Defconbots/2015_target/hw/boards/bom.md

## Control/Battery BOM

|Name |Quantity|Part Number |Distributor|
|:---:|:---:|:---:|:---:|
|BAT1, BAT2, BAT3|3 |534-082 |Mouser |
|U1 |1 |579-MCP1703T-3002ECB|Mouser |
|S1 |1 |612-EG1270 |Mouser |
|R1, R2, R3 |3 |71-CRCW0603-10K-E3  |Mouser |
|R4 |1 |71-CRCW0603220RFKEB |Mouser |
|U2 |1 |771-LPC824M201JDH20J|Mouser |
|JP2 |1 |798-DF132P125V20 |Mouser |
|JP3 |1 |798-DF134P125V20 |Mouser |
|U3 |1 |888-XB24CZ7PIS-004  |Mouser |
|C1, C2 |2 |C1608X5R1C106M080AB |Mouser |
|JP1 |1 |FTSH-105-01-L |Samtec |

## Target BOM

|Name |Quantity|Part Number |Distributor|
|:---:|:---:|:---:|:---:|
|D1, D2 |2 |150141RB73100 |Mouser |
|U1 |1 |579-MCP1703T-3002ECB|Mouser |
|U4 |1 |579-MCP6291T-E/OT |Mouser |
|D3 |1 |638-CLS1522CL213GTR8|Mouser |
|R7 |1 |71-CRCW0603-10K-E3  |Mouser |
|R2, R4 |2 |71-CRCW0603-5.6-E3  |Mouser |
|R5, R6 |2 |71-CRCW0603220RFKEB |Mouser |
|R8 |1 |71-CRCW06034M64FKEA |Mouser |
|R1, R3 |2 |71-CRCW060368R0FKEB |Mouser |
|T1 |1 |771-BC847BS-T/R |Mouser |
|U2 |1 |771-LPC824M201JDH20J|Mouser |
|JP1, JP2 |2 |798-DF134P125V20 |Mouser |
|C1, C2 |2 |C1608X5R1C106M080AB |Mouser |
|JP3 |1 |M50-3600542 |Mouser |

## Control/Target Interconnects

|Name |Quantity|Part Number |Distributor|
|:---:|:---:|:---:|:---:|
|N/A |1 |798-DF13-2S-1.25C |Mouser |
|N/A |11 |798-DF13-4S-1.25C |Mouser |
|N/A |30 |H4BBG-10110-B1-ND |Digikey |

## Misc Interface

|Name |Quantity|Part Number |Distributor|
|:---:|:---:|:---:|:---:|
|N/A |1 |602-1144-ND |Digikey |
|N/A |1 |771-OM13071598 |Mouser |
