Defconbots/2015_target/hw/boards/control_bat.brd

## EAGLE design hw/boards/control_bat.brd (2015-07-31)

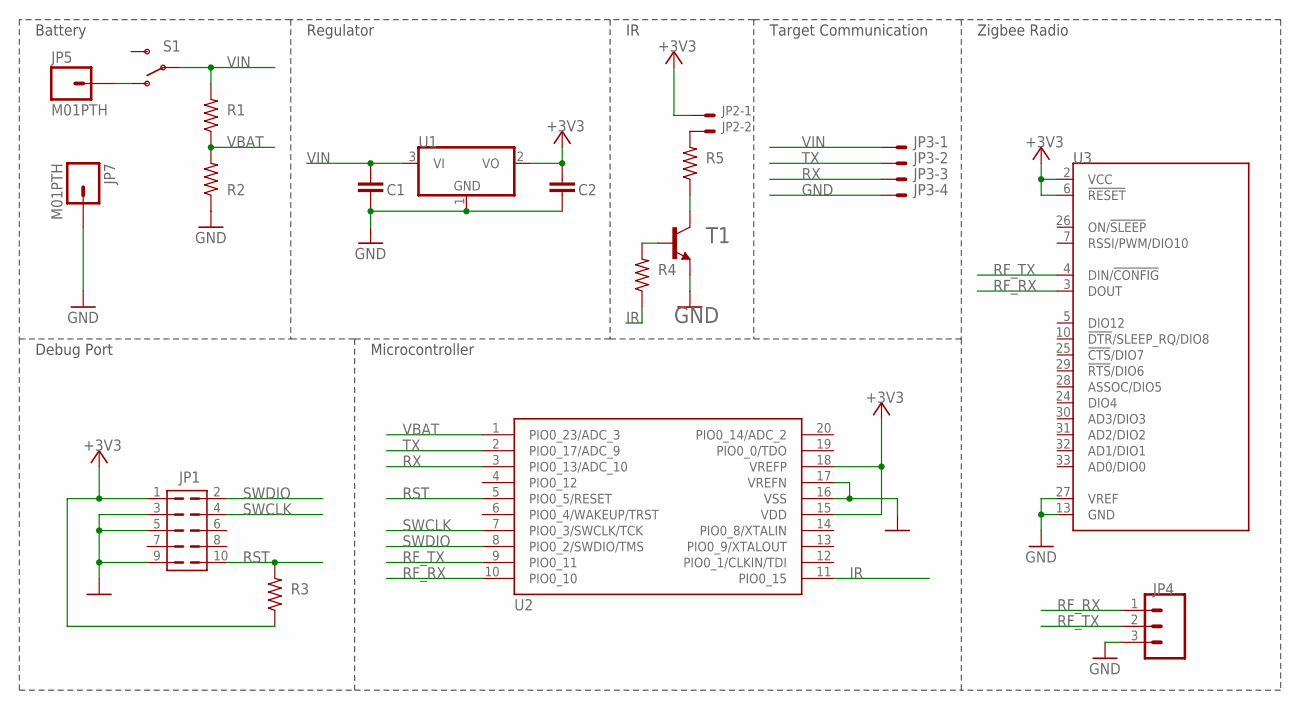
[picture p1: schematic control_bat.sch]

Parts:
C1, C2: C1608X5R1C106M080AB; 0603-CAP
JP1: FTSH-105-01-L; FTSH-105-01-XXX-DV-K
JP2: 798-DF132P125V20; 53398-02
JP3: 798-DF134P125V20; 53398-04
JP4: M03PTH; 1X03
JP5, JP7: M01PTH; 1X01
R1, R2, R3: 71-CRCW0603-10K-E3; R0603
R4: 71-CRCW0603220RFKEB; R0603
R5: 71-CRCW0603-5.6-E3; R0603
S1: 612-EG1270; EG1270
T1: PMBT4401,215; SOT23-BEC
U1: 579-MCP1703T-3002ECB; SOT23
U2: 771-LPC824M201JDH20J; TSSOP20
U3: 888-XB24CZ7PIS-004; XBEE-SMT

Connections:
+3V3: C2.1, JP1.1, JP2.1, R3.1, U1.2 (VO), U2.15 (VDD), U2.18 (VREFP), U3.2 (VCC), U3.6 (!RESET)
GND: C1.2, C2.2, JP1.3, JP1.5, JP1.9, JP3.4, JP4.3, JP7.1, R2.1, T1.E, U1.1 (GND), U2.16 (VSS), U2.17 (VREFN), U3.13 (GND), U3.27 (VREF)
IR: R4.1, U2.11 (PIO0_15)
unnamed: JP5.1, S1.P$1 (O)
unnamed: JP2.2, R5.2
unnamed: R5.1, T1.C
unnamed: R4.2, T1.B
RF_RX: JP4.1, U2.10 (PIO0_10), U3.3 (DOUT)
RF_TX: JP4.2, U2.9 (PIO0_11), U3.4 (DIN/!CONFIG)
RST: JP1.10, R3.2, U2.5 (PIO0_5/RESET)
RX: JP3.3, U2.3 (PIO0_13/ADC_10)
SWCLK: JP1.4, U2.7 (PIO0_3/SWCLK/TCK)
SWDIO: JP1.2, U2.8 (PIO0_2/SWDIO/TMS)
TX: JP3.2, U2.2 (PIO0_17/ADC_9)
VBAT: R1.1, R2.2, U2.1 (PIO0_23/ADC_3)
VIN: C1.1, JP3.1, R1.2, S1.P$2, U1.3 (VI)

Notes on the sheet:
Regulator
Microcontroller
Debug Port
Battery
Target Communication
Zigbee Radio

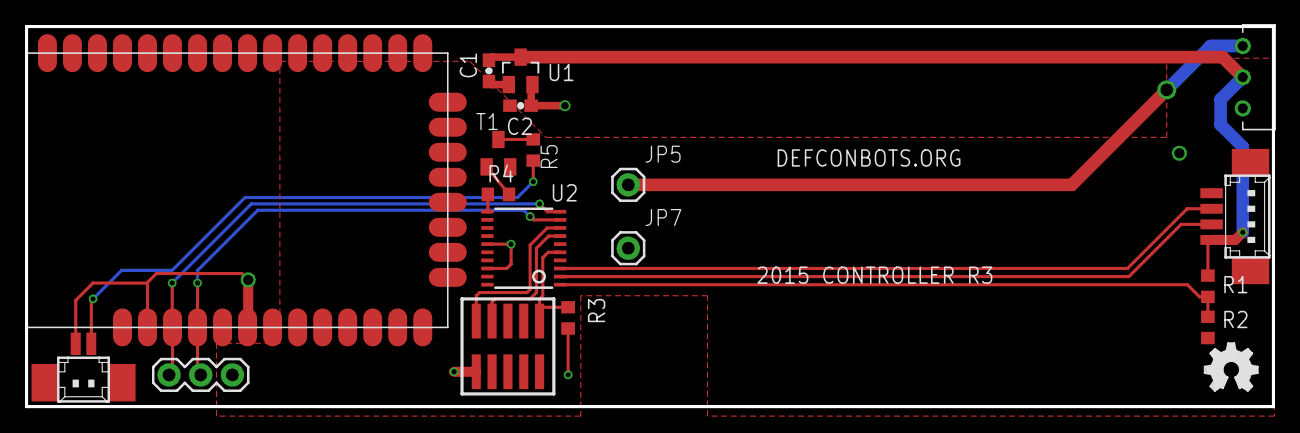
[picture p2: board control_bat.brd from above]

Board: 2 copper layers, 100.0 x 30.5 mm, 19 parts (0 on the bottom side), 16 nets.

Other parts of the board:
LOGO1: OSHW_LOGO_FILLX0150-NT; OSHW_FILLX150_NOTEXT
