Defconbots/2015_target/hw/boards/target.brd

## EAGLE design hw/boards/target.brd (2014-11-25)

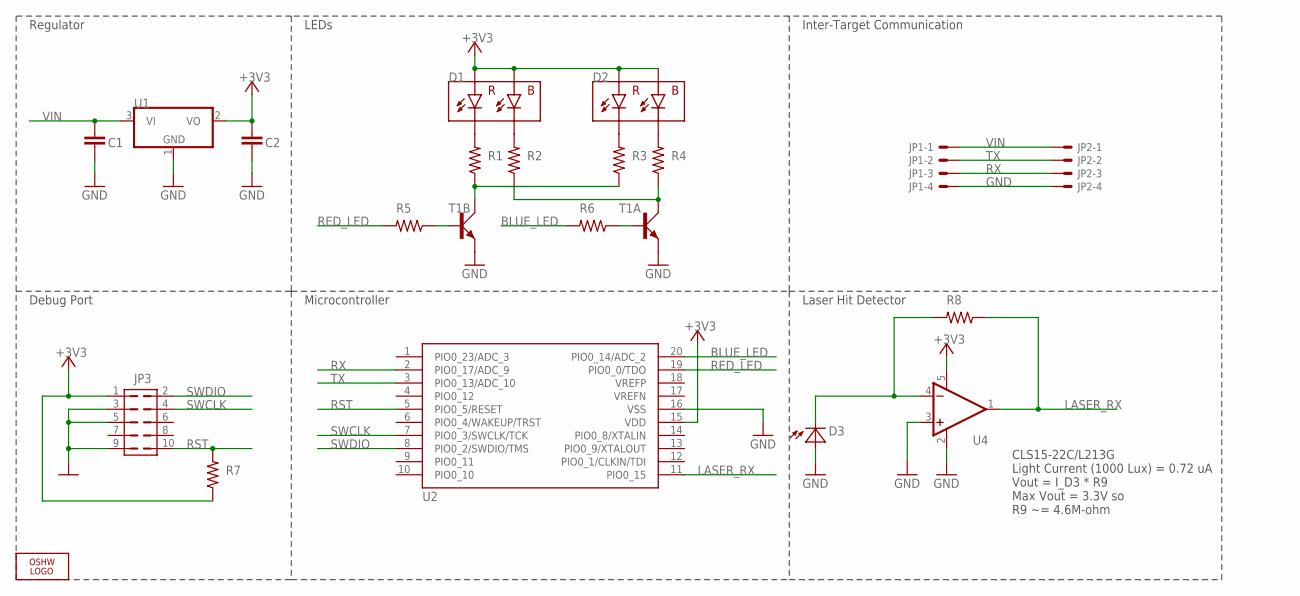
[picture p3: schematic target.sch]

Parts:
C1, C2: C1608X5R1C106M080AB; 0603-CAP
D1, D2: 150141RB73100; 150141RB
D3: 638-CLS1522CL213GTR8; CLS15
JP1, JP2: 798-DF134P125V20; 53398-04
JP3: FTSH-105-01-L; FTSH-105-01-XXX-DV-K
LOGO2: OSHW_LOGO_FILLX0150-NT; OSHW_FILLX150_NOTEXT
R1, R3: 71-CRCW060368R0FKEB; R0603
R2, R4: 71-CRCW0603-5.6-E3; R0603
R5, R6: 71-CRCW0603220RFKEB; R0603
R7: 71-CRCW0603-10K-E3; R0603
R8: 71-CRCW06034M64FKEA; R0603
T1: 771-BC847BS-T/R; SOT363_PHILIPS
U1: 579-MCP1703T-3002ECB; SOT23
U2: 771-LPC824M201JDH20J; TSSOP20
U4: 579-MCP6291T-E/OT; SOT23-5

Connections:
+3V3: C2.1, D1.1, D1.2, D2.1, D2.2, JP3.1, R7.1, U1.2 (VO), U2.15 (VDD), U4.5 (V+)
BLUE_LED: R6.2, U2.20 (PIO0_14/ADC_2)
GND: C1.2, C2.2, D3.1 (A), D3.2 (A), JP1.4, JP2.4, JP3.3, JP3.5, JP3.9, T1.1 (E), T1.4 (E), U1.1 (GND), U2.16 (VSS), U4.2 (V-), U4.3 (+IN)
LASER_RX: R8.1, U2.11 (PIO0_15), U4.1 (OUT)
unnamed: R2.1, R4.1, T1.6 (C)
unnamed: R1.1, R3.1, T1.3 (C)
unnamed: D1.3, R1.2
unnamed: R6.1, T1.2 (B)
unnamed: D3.3 (C), D3.4 (C), R8.2, U4.4 (-IN)
unnamed: D2.3, R3.2
unnamed: D1.4, R2.2
unnamed: D2.4, R4.2
unnamed: R5.1, T1.5 (B)
RED_LED: R5.2, U2.19 (PIO0_0/TDO)
RST: JP3.10, R7.2, U2.5 (PIO0_5/RESET)
RX: JP1.3, JP2.3, U2.2 (PIO0_17/ADC_9)
SWCLK: JP3.4, U2.7 (PIO0_3/SWCLK/TCK)
SWDIO: JP3.2, U2.8 (PIO0_2/SWDIO/TMS)
TX: JP1.2, JP2.2, U2.3 (PIO0_13/ADC_10)
VIN: C1.1, JP1.1, JP2.1, U1.3 (VI)

Notes on the sheet:
Regulator
LEDs
Inter-Target Communication
Microcontroller
Debug Port
Laser Hit Detector
CLS15-22C/L213G Light Current (1000 Lux) = 0.72 uA Vout = I_D3 * R9 Max Vout = 3.3V so R9 ~= 4.6M-ohm

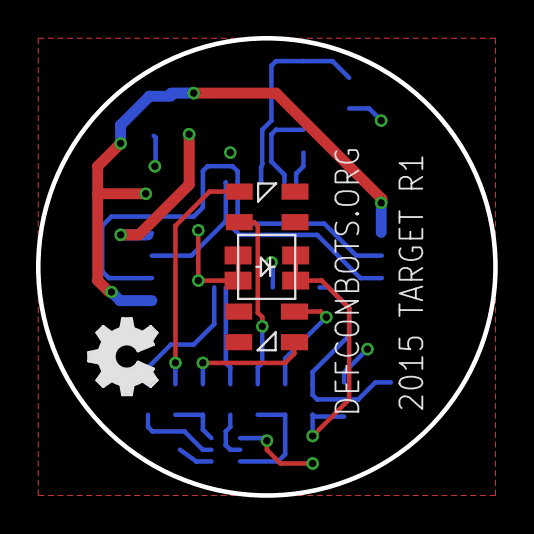
[picture p4: board target.brd from above]

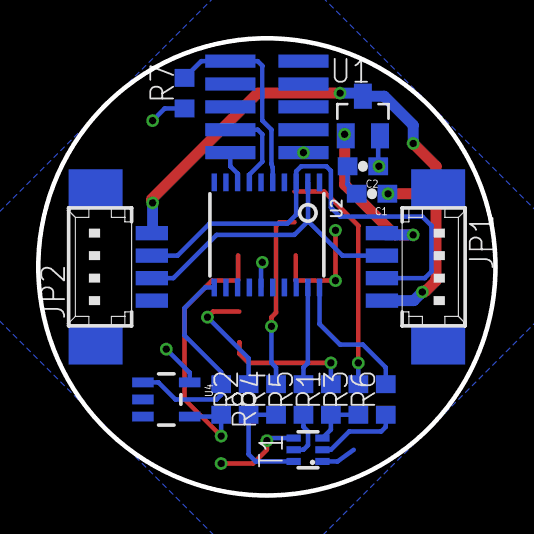
[picture p5: board target.brd from below]

Board: 2 copper layers, 25.4 x 25.4 mm, 21 parts (17 on the bottom side), 20 nets.
