Defconbots/2015_target/boards/main.brd

## EAGLE design boards/main.brd (2014-11-07)

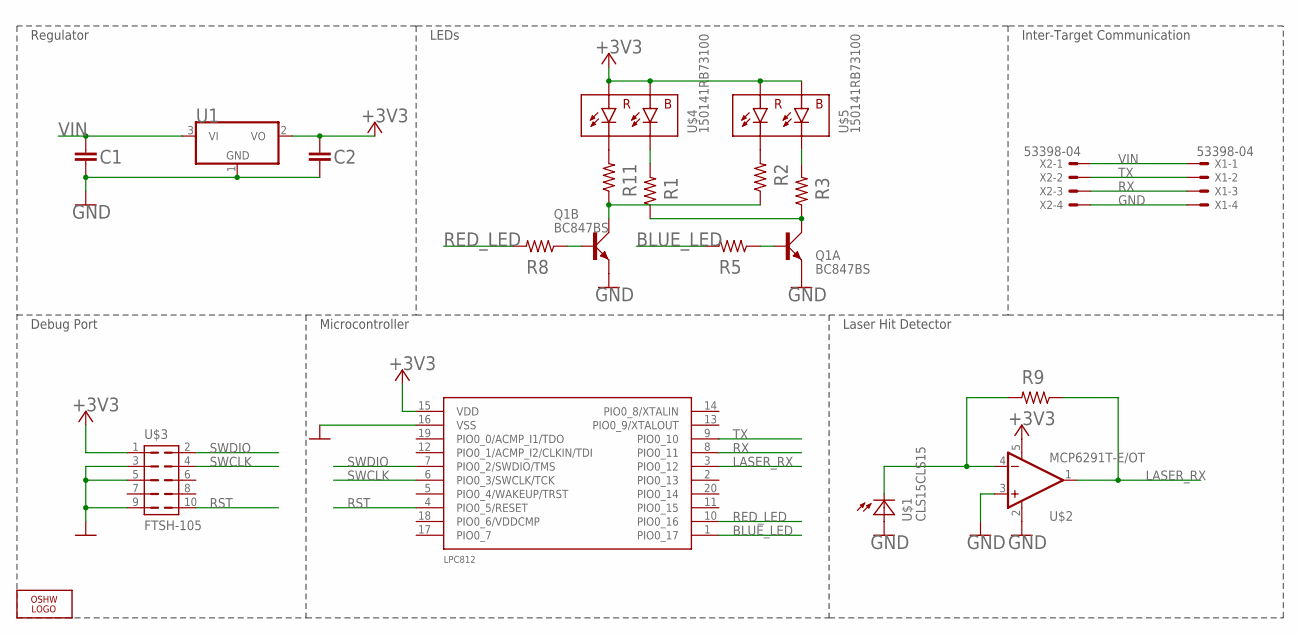
[picture p6: schematic main.sch]

Parts:
C1, C2: C1608X5R1C106M080AB; 0603-CAP
LOGO2: OSHW_LOGO_FILLX0150-NT; OSHW_FILLX150_NOTEXT
LPC812: LPC812M101JDH20; TSSOP20
Q1: BC847BS; SOT363_PHILIPS
R1, R2, R3, R5, R8, R9, R11: CRCW0603200RFKEA; R0603
U1: MCP1703T-3002E/CB; SOT23
U$1: CLS15CLS15; CLS15
U$2: MCP6291T-E/OT; SOT23-5
U$3: FTSH-105; FTSH-105-01-XXX-DV-K
U$4, U$5: 150141RB73100; 150141RB
X1, X2: 53398-04

Connections:
+3V3: C2.1, LPC812.15 (VDD), U1.2 (VO), U$2.5 (V+), U$3.1, U$4.1, U$4.2, U$5.1, U$5.2
BLUE_LED: LPC812.1 (PIO0_17), R5.2
GND: C1.2, C2.2, LPC812.16 (VSS), Q1.1 (E), Q1.4 (E), U1.1 (GND), U$1.1 (A), U$1.2 (A), U$2.2 (V-), U$2.3 (+IN), U$3.3, U$3.5, U$3.9, X1.4, X2.4
LASER_RX: LPC812.3 (PIO0_12), R9.1, U$2.1 (OUT)
unnamed: Q1.6 (C), R1.1, R3.1
unnamed: Q1.3 (C), R2.1, R11.1
unnamed: R11.2, U$4.3
unnamed: Q1.2 (B), R5.1
unnamed: R9.2, U$1.3 (C), U$1.4 (C), U$2.4 (-IN)
unnamed: R2.2, U$5.3
unnamed: R1.2, U$4.4
unnamed: R3.2, U$5.4
unnamed: Q1.5 (B), R8.1
RED_LED: LPC812.10 (PIO0_16), R8.2
RST: LPC812.4 (PIO0_5/RESET), U$3.10
RX: LPC812.8 (PIO0_11), X1.3, X2.3
SWCLK: LPC812.6 (PIO0_3/SWCLK/TCK), U$3.4
SWDIO: LPC812.7 (PIO0_2/SWDIO/TMS), U$3.2
TX: LPC812.9 (PIO0_10), X1.2, X2.2
VIN: C1.1, U1.3 (VI), X1.1, X2.1

Notes on the sheet:
Regulator
LEDs
Inter-Target Communication
Microcontroller
Debug Port
Laser Hit Detector

Board: 2 copper layers, 20 parts (16 on the bottom side), 20 nets, no tracks yet.
