Defconbots/2015_target/sw/driver_lib/inc/iocon_8xx.h

/*
 * @brief LPC8xx IOCON register block and driver
 *
 * @note
 * Copyright(C) NXP Semiconductors, 2012
 * All rights reserved.
 *
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
 * @par
 * Permission to use, copy, modify, and distribute this software and its
 * documentation is hereby granted, under NXP Semiconductors' and its
 * licensor's relevant copyrights in the software, without fee, provided that it
 * is used in conjunction with NXP Semiconductors microcontrollers.  This
 * copyright, permission, and disclaimer notice must appear in all copies of
 * this code.
 */

#ifndef __IOCON_8XX_H_
#define __IOCON_8XX_H_

#ifdef __cplusplus
extern "C" {
#endif

/** @defgroup IOCON_8XX CHIP: LPC8xx IOCON register block and driver
 * @ingroup CHIP_8XX_Drivers
 * @{
 */

#define NUM_IOCON_PIO  (29)

/**
 * @brief Array of IOCON pin definitions passed to Chip_IOCON_SetPinMuxing() must be in this format
 */
typedef struct {
	uint32_t pin:8;			/* Pin number */
	uint32_t modefunc:24;	/* Function and mode */
} PINMUX_GRP_T;

/**
 * @brief	IOCON register block structure
 * @note	When accessing this register structure, use the PIOn enumeration
 * as the array index as the pin assignments are not mapped 1-1 with the
 * IOCON structure.<br>
 * Incorrect: LPC_IOCON->PIO0[0] = 0x1; // Index 0 does not map to pin 0!<br>
 * Correct: LPC_IOCON->PIO0[IOCON_PIO0] = 0x1; // Enumeration PIO0 maps to pin 0
 */
typedef struct {		/*!< (@ 0x40044000) IOCONFIG Structure     */
	__IO uint32_t PIO0[NUM_IOCON_PIO + 2]; /* 2 added for reserved register */
} LPC_IOCON_T;

/**
 * @brief IOCON Register bit definitions
 */
/* Pin Mode mask */
#define PIN_MODE_MASK           (0x3 <<  3)
#define PIN_MODE_BITNUM         (3)

/* Pin Hysteresis mask */
#define PIN_HYS_MASK            (0x1 <<  5)
#define PIN_HYS_BITNUM          (5)

/* Pin invert input mask */
#define PIN_INV_MASK            (0x1 <<  6)
#define PIN_INV_BITNUM          (6)

/* Pin open drain mode mask */
#define PIN_OD_MASK             (0x1 << 10)
#define PIN_OD_BITNUM           (10)

/* Pin digital filter sample mode mask */
#define PIN_SMODE_MASK          (0x3 << 11)
#define PIN_SMODE_BITNUM        (11)

/* Pin clock divider mask */
#define PIN_CLKDIV_MASK         (0x7 << 13)
#define PIN_CLKDIV_BITNUM       (13)

/* Pin I2C mode mask - valid for PIO10 & PIO11 only */
#define PIN_I2CMODE_MASK        (0x3 <<  8)
#define PIN_I2CMODE_BITNUM      (8)

/**
 * @brief IOCON Pin Numbers enum
 * Maps a pin number to an IOCON (register) array index. IOCON indexes
 * are not mapped 1-1 with pin numbers. When access the PIO0 array in
 * the LPC_IOCON_T structure, the array should be indexed with one of
 * these enumerations based on the pin that will have it's settings
 * changed.<br>
 * Example: LPC_IOCON->PIO0[IOCON_PIO0] = 0x1; // Enumeration PIO0 maps to pin 0
 */
typedef enum CHIP_PINx {
	IOCON_PIO0  =  0x11,	/*!< PIN 0 */
	IOCON_PIO1  =  0x0B,	/*!< PIN 1 */
	IOCON_PIO2  =  0x06,	/*!< PIN 2 */
	IOCON_PIO3  =  0x05,	/*!< PIN 3 */
	IOCON_PIO4  =  0x04,	/*!< PIN 4 */
	IOCON_PIO5  =  0x03,	/*!< PIN 5 */
	/* The following pins are not present in DIP8 packages */
	IOCON_PIO6  =  0x10,	/*!< PIN 6 */
	IOCON_PIO7  =  0x0F,	/*!< PIN 7 */
	IOCON_PIO8  =  0x0E,	/*!< PIN 8 */
	IOCON_PIO9  =  0x0D,	/*!< PIN 9 */
	IOCON_PIO10 =  0x08,	/*!< PIN 10 */
	IOCON_PIO11 =  0x07,	/*!< PIN 11 */
	IOCON_PIO12 =  0x02,	/*!< PIN 12 */
	IOCON_PIO13 =  0x01,	/*!< PIN 13 */
	/* The following pins are not present in DIP8 & TSSOP16 packages */
	IOCON_PIO14 =  0x12,	/*!< PIN 14 */
	IOCON_PIO15 =  0x0A,	/*!< PIN 15 */
	IOCON_PIO16 =  0x09,	/*!< PIN 16 */
	IOCON_PIO17 =  0x00,	/*!< PIN 17 */
	IOCON_PIO_NUL0 = 0x0C,	/*!< PIN NULL */

	/* The following pins are not present in DIP8, TSSOP16 & TSSOP20 packages */
	IOCON_PIO18 =  0x1E,	/*!< PIN 18 */
	IOCON_PIO19 =  0x1D,	/*!< PIN 19 */
	IOCON_PIO20 =  0x1C,	/*!< PIN 20 */
	IOCON_PIO21 =  0x1B,	/*!< PIN 21 */
	IOCON_PIO22 =  0x1A,	/*!< PIN 22 */
	IOCON_PIO23 =  0x19,	/*!< PIN 23 */
	IOCON_PIO24 =  0x18,	/*!< PIN 24 */
	IOCON_PIO25 =  0x17,	/*!< PIN 25 */
	IOCON_PIO26 =  0x16,	/*!< PIN 26 */
	IOCON_PIO27 =  0x15,	/*!< PIN 27 */
	IOCON_PIO28 =  0x14,	/*!< PIN 28 */
	IOCON_PIO_NUL1 = 0x13,	/*!< PIN NULL */
} CHIP_PINx_T;

/**
 * @brief IOCON Pin Modes enum
 */
typedef enum CHIP_PIN_MODE {
	PIN_MODE_INACTIVE = 0,	/*!< Inactive mode */
	PIN_MODE_PULLDN = 1,	/*!< Pull Down mode */
	PIN_MODE_PULLUP = 2,	/*!< Pull up mode */
	PIN_MODE_REPEATER = 3	/*!< Repeater mode */
} CHIP_PIN_MODE_T;

/**
 * @brief IOCON Digital Filter Sample modes enum
 */
typedef enum CHIP_PIN_SMODE {
	PIN_SMODE_BYPASS = 0,	/*!< Bypass input filter */
	PIN_SMODE_CYC1 = 1,		/*!< Input pulses shorter than 1 filter clock cycle are rejected */
	PIN_SMODE_CYC2 = 2,		/*!< Input pulses shorter than 2 filter clock cycles are rejected */
	PIN_SMODE_CYC3 = 3		/*!< Input pulses shorter than 3 filter clock cycles are rejected */
} CHIP_PIN_SMODE_T;

/**
 * @brief IOCON I2C Modes enum (Only for I2C pins PIO0_10 and PIO0_11)
 */
typedef enum CHIP_PIN_I2CMODE {
	PIN_I2CMODE_STDFAST = 0,	/*!< I2C standard mode/Fast mode */
	PIN_I2CMODE_GPIO = 1,		/*!< Standard I/O functionality */
	PIN_I2CMODE_FASTPLUS = 2	/*!< I2C Fast plus mode */
} CHIP_PIN_I2CMODE_T;

void Chip_IOCON_Init(void);

void Chip_IOCON_Deinit(void);

/**
 * @brief	Sets I/O Control pin mux
 * @param	pIOCON		: The base of IOCON peripheral on the chip
 * @param	pin			: GPIO pin to mux
 * @param	modefunc	: OR'ed values or type IOCON_*
 * @return	Nothing
 */
STATIC INLINE void Chip_IOCON_PinMuxSet(LPC_IOCON_T *pIOCON, uint8_t pin, uint32_t modefunc)
{
	pIOCON->PIO0[pin] = modefunc;
}

/**
 * @brief	Set all I/O Control pin muxing
 * @param	pIOCON	    : The base of IOCON peripheral on the chip
 * @param	pinArray    : Pointer to array of pin mux selections
 * @param	arrayLength : Number of entries in pinArray
 * @return	Nothing
 */
void Chip_IOCON_SetPinMuxing(LPC_IOCON_T *pIOCON, const PINMUX_GRP_T* pinArray, uint32_t arrayLength);

/**
 * @brief	Sets pull-up or pull-down mode for a pin
 * @param	pIOCON	: The base of IOCON peripheral on the chip
 * @param	pin		: Pin number
 * @param	mode	: Mode (Pull-up/Pull-down mode)
 * @return	Nothing
 * @note	Do not use with pins PIO10 and PIO11.
 */
void Chip_IOCON_PinSetMode(LPC_IOCON_T *pIOCON, CHIP_PINx_T pin, CHIP_PIN_MODE_T mode);

/**
 * @brief	Enable or disable hysteresis for a pin
 * @param	pIOCON	: The base of IOCON peripheral on the chip
 * @param	pin		: Pin number
 * @param	enable	: true to enable, false to disable
 * @return	Nothing
 * @note	Do not use with pins PIO10 and PIO11.
 */
void Chip_IOCON_PinSetHysteresis(LPC_IOCON_T *pIOCON, CHIP_PINx_T pin, bool enable);

/**
 * @brief	Enable hysteresis for a pin
 * @param	pIOCON	: The base of IOCON peripheral on the chip
 * @param	pin		: Pin number
 * @return	Nothing
 * @note	Do not use with pins PIO10 and PIO11.
 */
STATIC INLINE void Chip_IOCON_PinEnableHysteresis(LPC_IOCON_T *pIOCON, CHIP_PINx_T pin)
{
	pIOCON->PIO0[pin] |= PIN_HYS_MASK;
}

/**
 * @brief	Disable hysteresis for a pin
 * @param	pIOCON	: The base of IOCON peripheral on the chip
 * @param	pin		: Pin number
 * @return	Nothing
 * @note	Do not use with pins PIO10 and PIO11.
 */
STATIC INLINE void Chip_IOCON_PinDisableHysteresis(LPC_IOCON_T *pIOCON, CHIP_PINx_T pin)
{
	pIOCON->PIO0[pin] &= ~PIN_HYS_MASK;
}

/**
 * @brief	Enable or disable invert input for a pin
 * @param	pIOCON	: The base of IOCON peripheral on the chip
 * @param	pin		: Pin number
 * @param	invert	: true to invert, false to not to invert
 * @return	Nothing
 */
void Chip_IOCON_PinSetInputInverted(LPC_IOCON_T *pIOCON, CHIP_PINx_T pin, bool invert);

/**
 * @brief	Enable invert input for a pin
 * @param	pIOCON	: The base of IOCON peripheral on the chip
 * @param	pin		: Pin number
 * @return	Nothing
 */
STATIC INLINE void Chip_IOCON_PinEnableInputInverted(LPC_IOCON_T *pIOCON, CHIP_PINx_T pin)
{
	pIOCON->PIO0[pin] |= PIN_INV_MASK;
}

/**
 * @brief	Disable invert input for a pin
 * @param	pIOCON	: The base of IOCON peripheral on the chip
 * @param	pin		: Pin number
 * @return	Nothing
 */
STATIC INLINE void Chip_IOCON_PinDisableInputInverted(LPC_IOCON_T *pIOCON, CHIP_PINx_T pin)
{
	pIOCON->PIO0[pin] &= ~PIN_INV_MASK;
}

/**
 * @brief	Enables or disables open-drain mode for a pin
 * @param	pIOCON		: The base of IOCON peripheral on the chip
 * @param	pin			: Pin number
 * @param	open_drain	: true to enable open-drain mode,
 *                        false to disable open-drain mode
 * @return	Nothing
 */
void Chip_IOCON_PinSetOpenDrainMode(LPC_IOCON_T *pIOCON, CHIP_PINx_T pin, bool open_drain);

/**
 * @brief	Enables open-drain mode for a pin
 * @param	pIOCON		: The base of IOCON peripheral on the chip
 * @param	pin			: Pin number
 * @return	Nothing
 */
STATIC INLINE void Chip_IOCON_PinEnableOpenDrainMode(LPC_IOCON_T *pIOCON, CHIP_PINx_T pin)
{
	pIOCON->PIO0[pin] |= PIN_OD_MASK;
}

/**
 * @brief	Disables open-drain mode for a pin
 * @param	pIOCON		: The base of IOCON peripheral on the chip
 * @param	pin			: Pin number
 * @return	Nothing
 */
STATIC INLINE void Chip_IOCON_PinDisableOpenDrainMode(LPC_IOCON_T *pIOCON, CHIP_PINx_T pin)
{
	pIOCON->PIO0[pin] &= ~PIN_OD_MASK;
}

/**
 * @brief	Sets the digital filter sampling mode for a pin
 * @param	pIOCON	: The base of IOCON peripheral on the chip
 * @param	pin		: Pin number
 * @param	smode	: 0x0 = bypass, 0x[1..3] = 1 to 3 clock cycles.
 * @return	Nothing
 */
void Chip_IOCON_PinSetSampleMode(LPC_IOCON_T *pIOCON, CHIP_PINx_T pin, CHIP_PIN_SMODE_T smode);

/**
 * @brief	Select peripheral clock divider for input filter sampling clock
 * @param	pIOCON	: The base of IOCON peripheral on the chip
 * @param	pin		: Pin number
 * @param	clkdiv	: 0 = no divisor, 1...6 = PCLK/clkdiv
 * @return	Nothing
 */
void Chip_IOCON_PinSetClockDivisor(LPC_IOCON_T *pIOCON, CHIP_PINx_T pin, CHIP_PIN_CLKDIV_T clkdiv);

/**
 * @brief	Set I2C mode for a pin
 * @param	pIOCON	: The base of IOCON peripheral on the chip
 * @param	pin		: Pin number
 * @param	mode	: 0:Standard/Fast I2C 1: GPIO 2: Fast Plus
 * @return	Nothing
 * @note	Valid for pins PIO0_10 and PIO0_11 only.
 */
void Chip_IOCON_PinSetI2CMode(LPC_IOCON_T *pIOCON, CHIP_PINx_T pin, CHIP_PIN_I2CMODE_T mode);

/**
 * @}
 */

#ifdef __cplusplus
}
#endif

#endif /* __IOCON_8XX_H_ */
