Defconbots/2015_target/sw/TargetFirmware/src/delay.c

#include "global.h"
#include "delay.h"
#include "schedule.h"

//::::::::::::::::::::::::::::::::::::::::::::::::::::::::::::::::::::::::::::::
void Delay(uint32_t delay_time)
{
    uint32_t start_time = g_now;
    while(g_now < (start_time + delay_time));
}

//::::::::::::::::::::::::::::::::::::::::::::::::::::::::::::::::::::::::::::::
void DelayDumb(uint32_t delay_time)
{
    volatile uint32_t cnt = 0;
    while(cnt++ < delay_time);
}
