Defconbots/2015_target/(commit log)

2014-11-04 A start.
    [main.brd, main.sch]
2014-11-05 Rough schematic, aproximate placement.
    [main.brd, main.sch]
2014-11-07 Swap msp430 for LPC8* arm processor. Add battery/controller-radio board
    [control_bat.brd, control_bat.sch, main.brd, main.sch]
2014-11-08 First pass layout of control/battery board
    [control_bat.brd, control_bat.sch]
2014-11-08 Add serial debug port on xbee in case I need to configure it manually
    [control_bat.brd, control_bat.sch]
2014-11-08 Some ground plane improvements
    [control_bat.brd]
2014-11-08 Fix footprint (was footprint for LPC812 instead of LPC824). Update part numbers on the schematic. Add IR. Cleanup ground plane.
    [control_bat.brd, control_bat.sch]
2014-11-08 Probably not a bad idea to have a pullup on the reset line.
    [control_bat.brd, control_bat.sch]
2014-11-08 Add a junction...
    [control_bat.sch]
2014-11-08 Rename to target.sch/brd. Fix controller. Add part numbers. Still needs to be routed.
    [target.brd, target.sch]
2014-11-08 Fix overlap
    [control_bat.brd]
2014-11-09 Working on target layout
    [target.brd, target.sch]
2014-11-09 First pass target route
    [target.brd, target.sch]
2014-11-23 Add start of TargetControl app
    [control_bat.brd, control_bat.sch, target.brd, target.sch]
2014-11-24 Cleanup some routing. Fix some part numbers
    [control_bat.brd, control_bat.sch, target.brd]
2014-11-24 Cleanup some parts, generate BOM.
    [control_bat.brd, control_bat.sch, target.brd, target.sch]
2014-11-24 Panelize the boards for fab
    [panel.brd]
2014-11-24 Fix some part numbers
    [target.brd, target.sch]
2014-11-24 Fix fonts
    [control_bat.brd]
2014-11-24 Panel was missing some holes for breakoff
    [panel.brd]
2014-11-24 Gerbers from the panel.
2014-11-24 Switch to use Caliburn micro MVVM
2014-11-25 Get rid of the panel, prep for proto order with dirty PCBs.
    [control_bat.brd, panel.brd, target.brd]
2014-11-25 fix silkscreen
    [control_bat.brd]
2014-11-25 Fix length to be 10cm
    [control_bat.brd]
2014-11-25 Fix silkscreen. again.
    [target.brd]
2014-11-25 Add individual gerbers.
2014-12-01 Update driver lib to LPCopen 2.03. Structure initial target controller.
    I don't have hardware so nothing is tested at this point. Just laying the groundwork for the eventual application.
2014-12-02 Fill in all the sci functions. Add target framework.
2014-12-03 Fix some casts. Make target only respond to '*' address from the laser.
    [target.c]
2014-12-03 Add the xstick driver so no one has to go looking for it.
2014-12-16 Fix adc.
    There is no internal reference so I needed to connect the VREFP/VREFN pints to VCC/GND. Added init code to read single adc samples when the voltage-read command is passed.
    [control_bat.brd, control_bat.sch]
2014-12-18 Working on the train IR reverse engineering. PWM works but not the actual signaling.
2014-12-19 Fix schedule tick time to be 1ms. This also fixed the train speed signaling.
    [schedule.c]
2015-01-25 All commands are up and running but the RX from targets is erratic, possibly due to noise.
    Here are a few major findings:
    - There is an interaction between the ADC and the RX line on the controller board. I fixed it by disabling the ADC pin when not in use but needed to add an enable-delay-disable in the voltage-read function.
    - The tx/rx on the target board is swapped so I swapped it in the uart init.
    - The uart speed was changed from 115k to 56k, but it hasn't seem to make the link more reliable -- will possibly change it back in the future.
    [controller.c, global.h, sci.c, sci.h, target.c]
2015-01-25 Update driver lib to lpcopen 2.15
2015-01-25 Fix ADC sequency from killing the serial RX.
    For some reason when the ADC sequencer is running it killed the rx port. Initially I thought rx performance was erratic but it turns out after any ADC reading it would stop working. Fixed by disabling the sequencer when not in use.
    [controller.c]
2015-05-13 Fix tx bus problem.
    All targets share the same tx-rx lines. The RX lines float but, by default, the TX line has an internal pull-up. Whenever more than 2 targets were attached the logic-voltage of the tx line would only drop by 1/3rd (or 1/4th-1/5th, etc for the length of the bus) instead of going from VCC to 0. To fix this during the transmit I move the tx function to the tx line and when I'm done I move it to a spare IO and let the original tx pin float.
    [target.c, target_hw.h]
2015-06-14 Update SCI to add address and device data to responses. Update SCI access accordingly. Fix bug where stop byte of response packets was incorrect because we weren't waiting long enough after a transmi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
    [controller.c, sci.c, sci.h, target.c]
2015-07-05 Add address to error response and make LEDs turn off all the way when you set brightness to 0.
    [sci.c, target.c, target_hw.h]
2015-07-26 Ir LED handling not PWM anymore. Now constantly sends.
2015-07-26 Fix issue with targets not releasing the tx line on the bus occasionally.
    [target.c]
2015-07-29 Switch ir pin back to PWM.
    So I originally used a scope and reverse engineered the IR protocol noting a 40khz carrier freq. Months later, when I was debugging the code, I didn't have a scope and used a logic analyzer instead, but didn't see the carrier. After many hours of debug I decided to order new scope probes (since the old probes were lost in a house fire) and debug the protocol again. I found again, there is a carrier, and added it back in. Now it works and all is right in the world.
    [controller.c, controller_hw.h]
2015-07-31 Final fixes to the controller board.
    This board will probably never be fabbed but I'm documenting the fixes made to hardware here for future reference.
    [control_bat.brd, control_bat.sch]
